M4dm0nky/madbuddy/docs/einbau-kamera-roboter.pdf

# 📷 Kamera und XIAO in den Roboter einbauen

MadBuddy Stufe 3 „Roboter“ · Dauer ca. 10 Minuten · kein Kleber, kein Löten bei diesem Schritt

## 🧩 Das Prinzip

Die Kamera sitzt innen in der Brust und schaut durch ein kleines Loch (Ø 7,4 mm) nach vorn. Kamera und XIAO bleiben so, wie sie geliefert werden: Die Kameraplatine steckt auf dem XIAO über dem SD-Steckplatz. Beides geht als ein Block von hinten in die Brust. Kein Riegel, kein Kleber, keine Schrauben an dieser Stelle. Alle Bilder zeigen das Brust-Vorderteil von hinten, so wie es vor dir liegt, wenn die Rückwand ab ist.

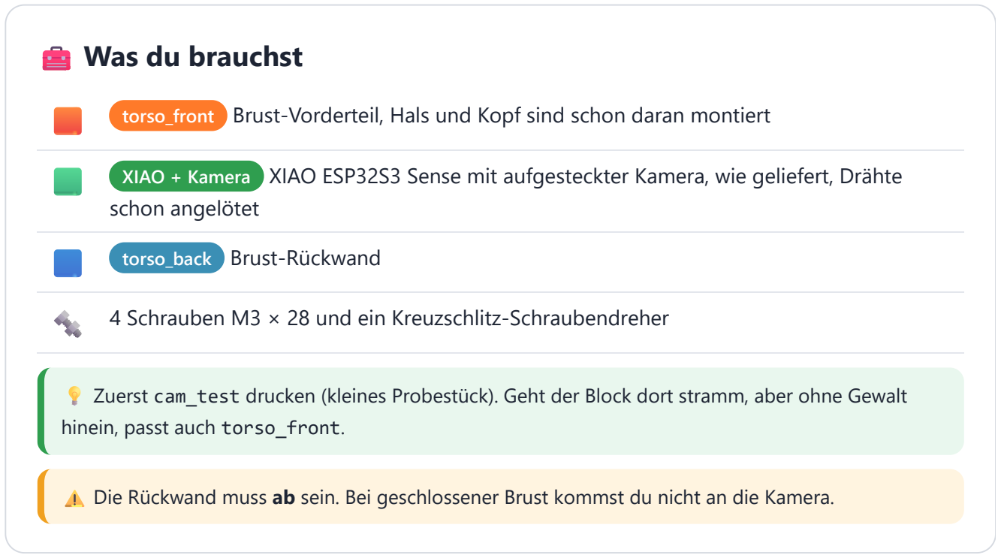
[picture p6: figure]
🧰 Was du brauchst; schon angelötet; torso_back Brust-Rückwand; hinein, passt auch torso_front.

🟧 | torso_front Brust-Vorderteil, Hals und Kopf sind schon daran montiert
🟩 | XIAO + Kamera XIAO ESP32S3 Sense mit aufgesteckter Kamera, wie geliefert, Drähte

🔩 4 Schrauben M3 × 28 und ein Kreuzschlitz-Schraubendreher

💡 Zuerst cam_test drucken (kleines Probestück). Geht der Block dort stramm, aber ohne Gewalt

⚠️ Die Rückwand muss ab sein. Bei geschlossener Brust kommst du nicht an die Kamera.

## 1 Leere Tasche

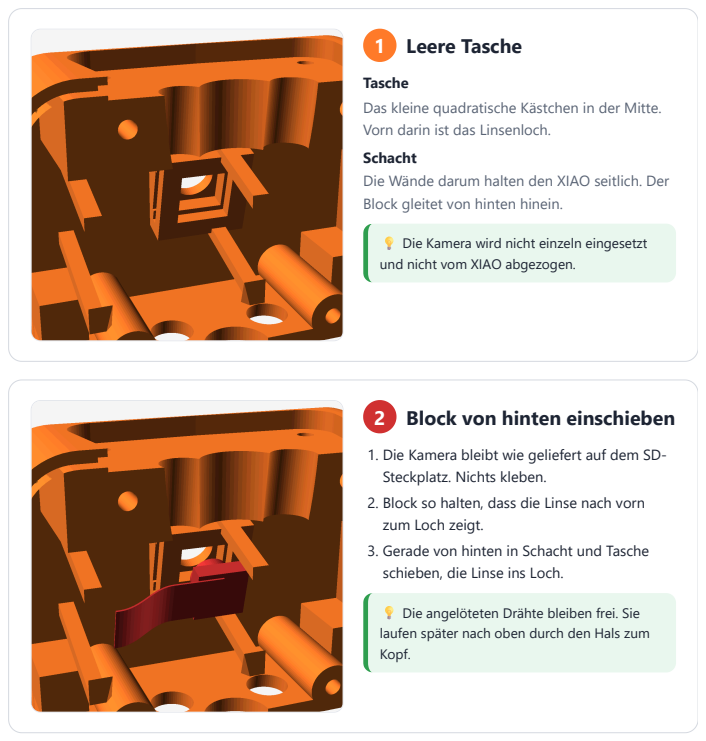
[picture p7: page 2]

Tasche
Das kleine quadratische Kästchen in der Mitte.
Vorn darin ist das Linsenloch.
Schacht
Die Wände darum halten den XIAO seitlich. Der
Block gleitet von hinten hinein.

💡 Die Kamera wird nicht einzeln eingesetzt
und nicht vom XIAO abgezogen.

2 Block von hinten einschieben

1. Die Kamera bleibt wie geliefert auf dem SD-
Steckplatz. Nichts kleben.
2. Block so halten, dass die Linse nach vorn
zum Loch zeigt.
3. Gerade von hinten in Schacht und Tasche
schieben, die Linse ins Loch.

💡 Die angelöteten Drähte bleiben frei. Sie
laufen später nach oben durch den Hals zum
Kopf.

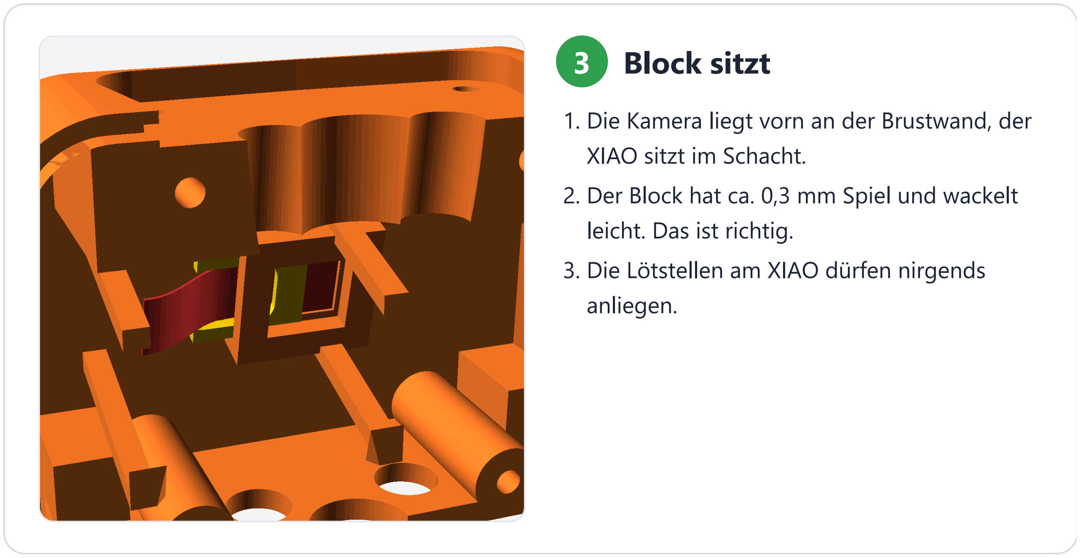
[picture p8: figure]
3 Block sitzt; XIAO sitzt im Schacht.; leicht. Das ist richtig.; anliegen.

1. Die Kamera liegt vorn an der Brustwand, der
2. Der Block hat ca. 0,3 mm Spiel und wackelt
3. Die Lötstellen am XIAO dürfen nirgends

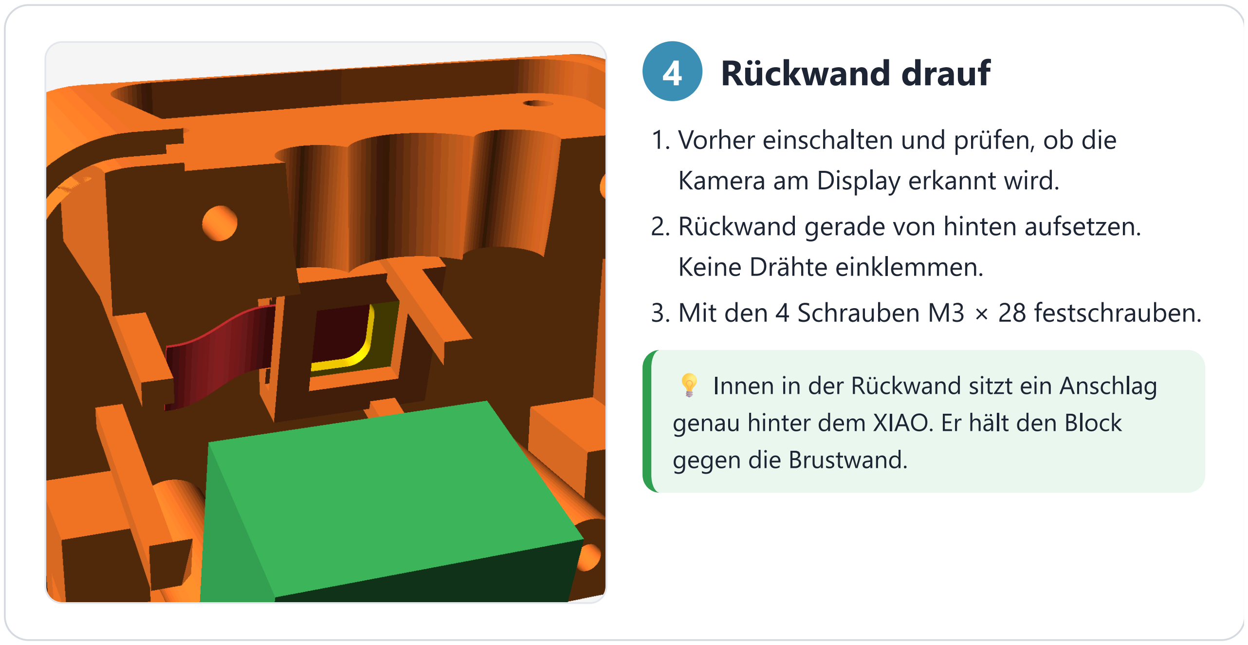
[picture p9: figure]
4 Rückwand drauf; Kamera am Display erkannt wird.; Keine Drähte einklemmen.; gegen die Brustwand.

1. Vorher einschalten und prüfen, ob die
2. Rückwand gerade von hinten aufsetzen.
3. Mit den 4 Schrauben M3 × 28 festschrauben.

💡 Innen in der Rückwand sitzt ein Anschlag genau hinter dem XIAO. Er hält den Block

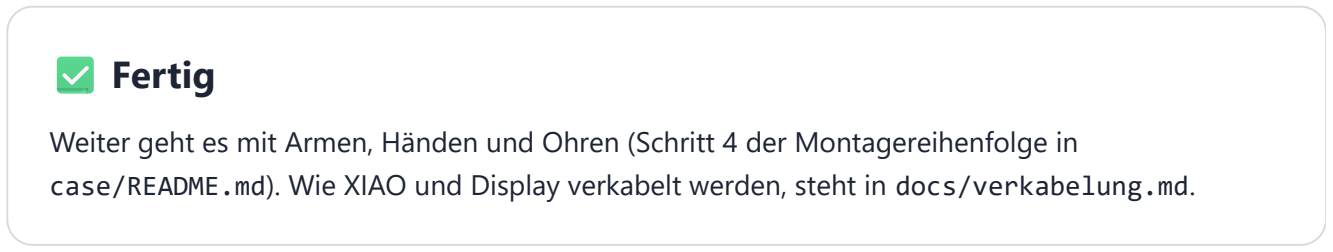
[picture p10: figure]
✅ Fertig

Weiter geht es mit Armen, Händen und Ohren (Schritt 4 der Montagereihenfolge in case/README.md). Wie XIAO und Display verkabelt werden, steht in docs/verkabelung.md.

MadBuddy · Bilder aus dem Gehäusemodell (case/tools/render_guide.ps1) · Stand 2026-11-06
