M4dm0nky/madbuddy/case/render/madbuddy_front.png

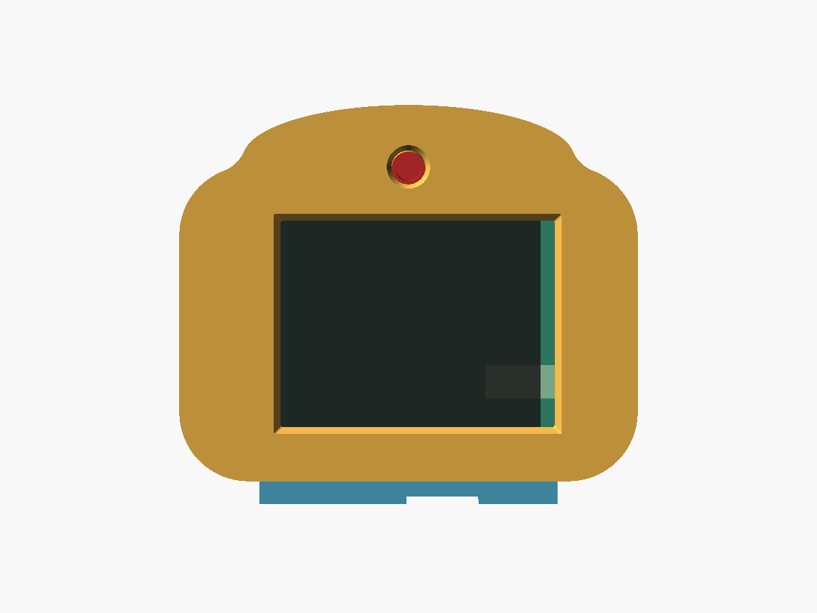
case/render/madbuddy_front.png
