M4dm0nky/madbuddy/case/render/madbuddy_hinten.png

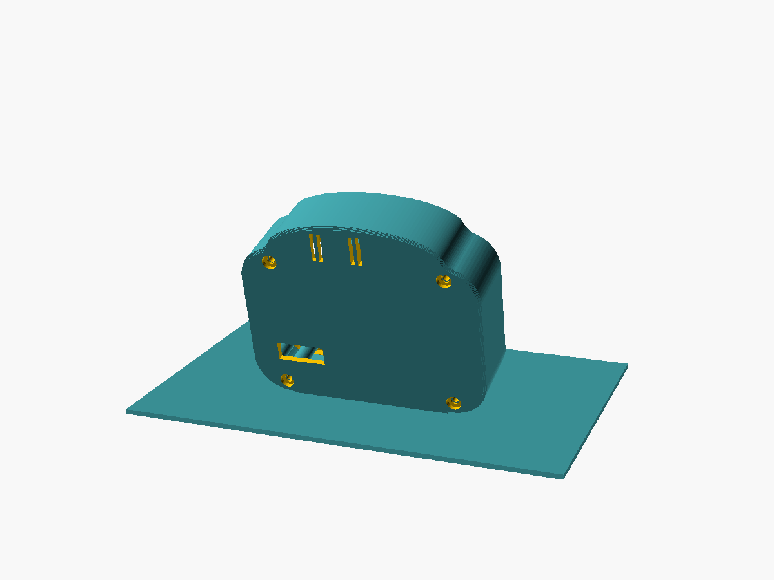
case/render/madbuddy_hinten.png
