M4dm0nky/madbuddy/case/render/madbuddy_kamera_schnitt.png

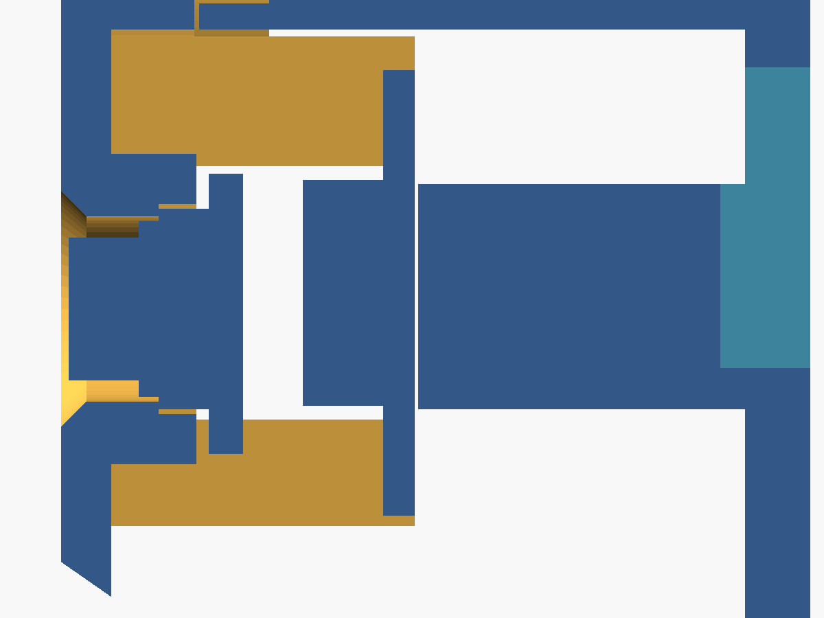
case/render/madbuddy_kamera_schnitt.png
