M4dm0nky/madbuddy/case/render/madbuddy_schnitt.png

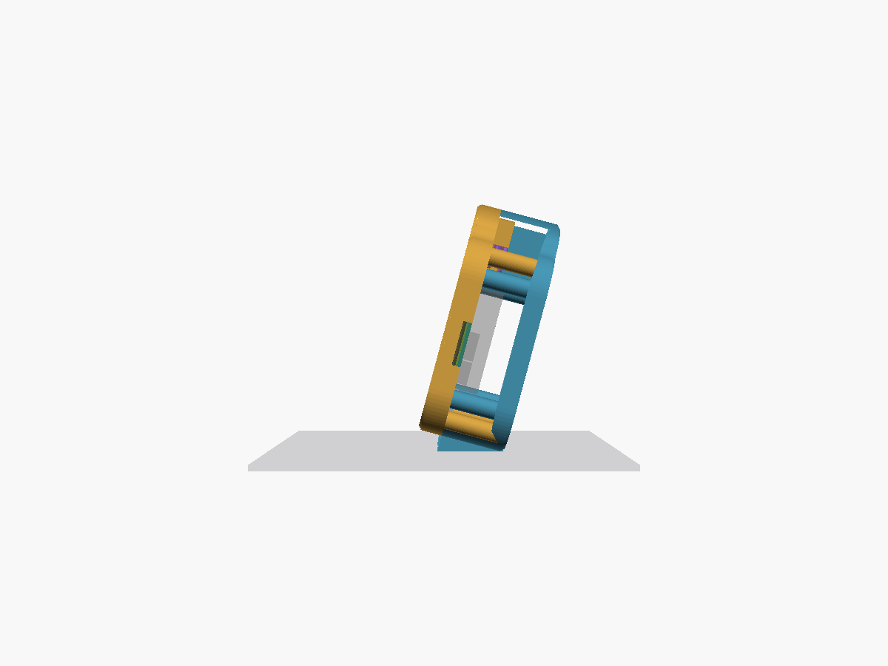
case/render/madbuddy_schnitt.png
