M4dm0nky/madbuddy/case/render/roboter_exploded.png

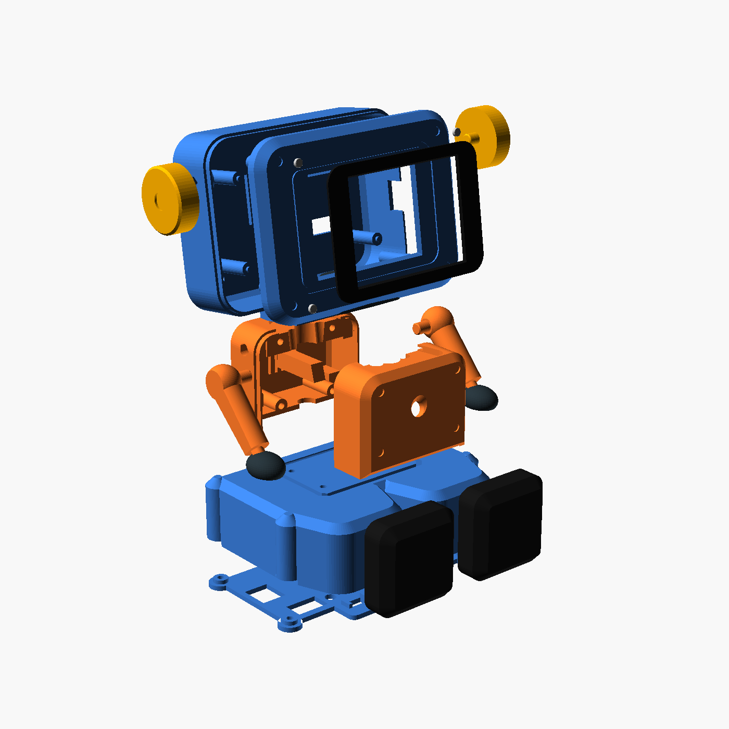
case/render/roboter_exploded.png
