M4dm0nky/madbuddy/case/render/roboter_section.png

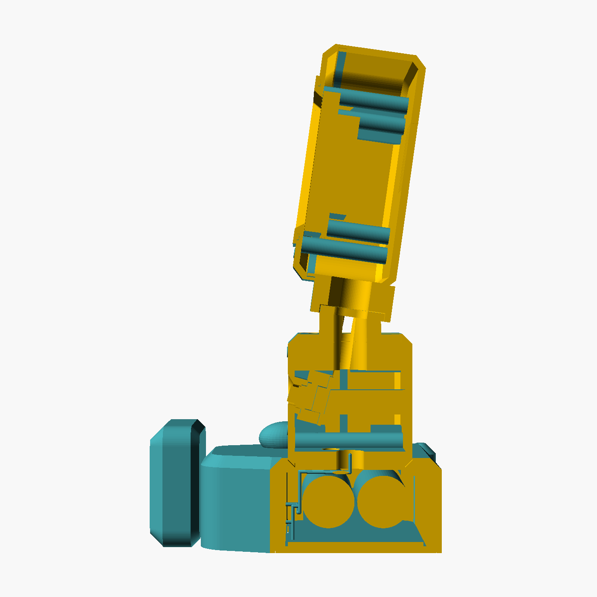
case/render/roboter_section.png
