M4dm0nky/madbuddy/case/stl/roboter_deco.stl

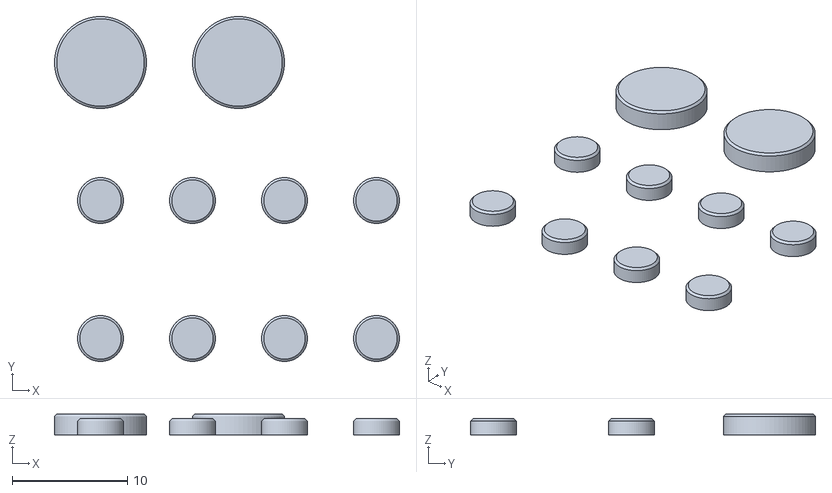
[picture p18: CAD file, 2026-11-06]
case/stl/roboter_deco.stl
30.0 x 30.0 x 1.80
