M4dm0nky/madbuddy/case/3mf/roboter_ams.3mf

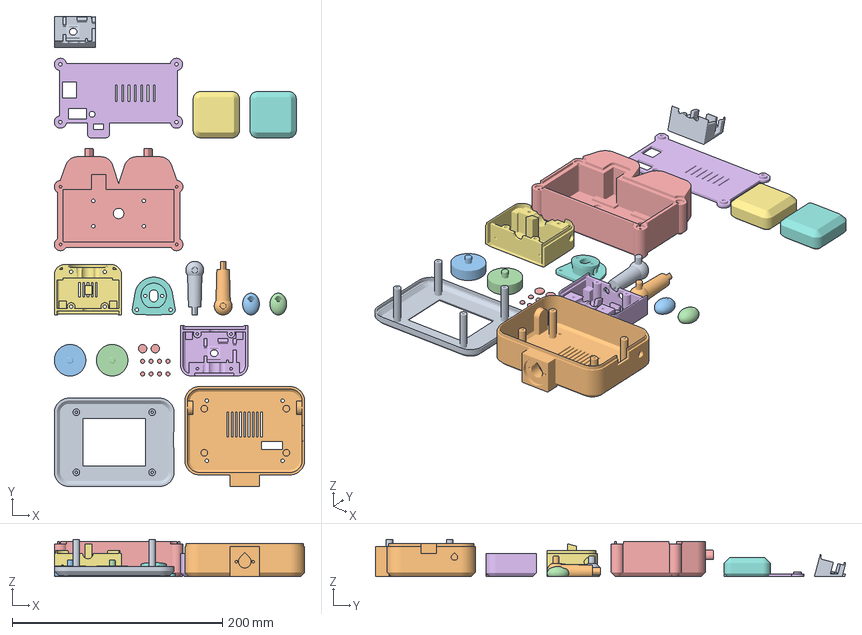
[picture p19: CAD file, 2026-11-05]
case/3mf/roboter_ams.3mf
238.0 x 446.7 x 35.5 mm
kopf
head_back
ear_r
ear_l
deco
torso_front
torso_back
neck
arm_r
arm_l
hand_r
hand_l
seat
bottom
foot_r
foot_l
cam_test
