M4dm0nky/madbuddy/case/stl/roboter_ear.stl

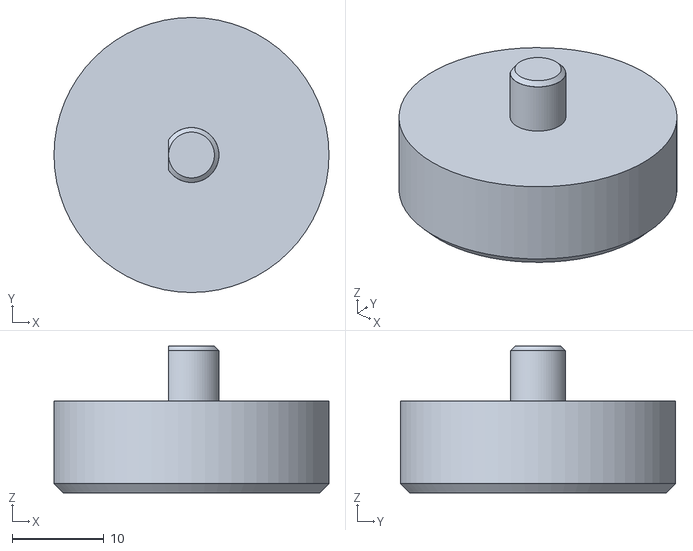
[picture p20: CAD file, 2026-11-06]
case/stl/roboter_ear.stl
30.0 x 30.0 x 16.0
