M4dm0nky/madbuddy/case/stl/roboter_hand.stl

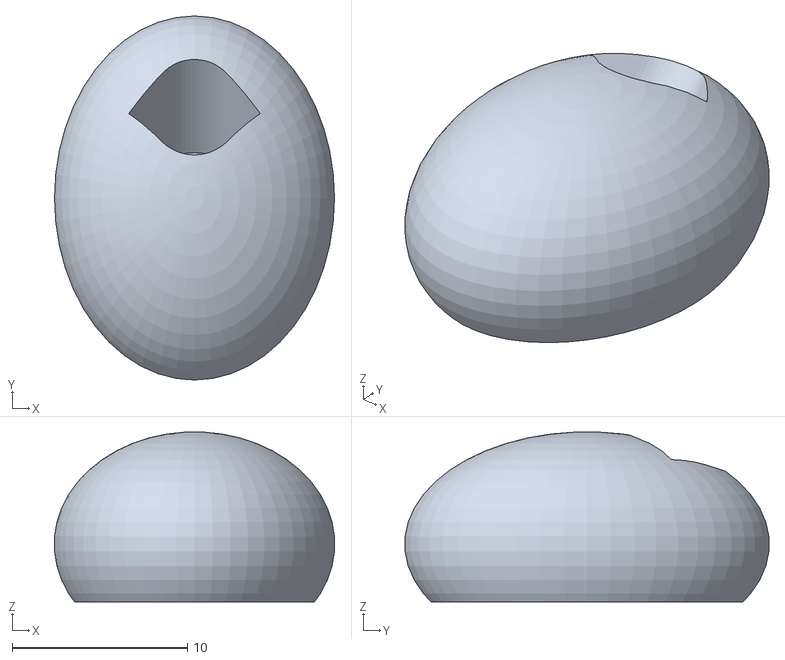
[picture p21: CAD file, 2026-11-06]
case/stl/roboter_hand.stl
16.0 x 20.8 x 9.69
