M4dm0nky/madbuddy/case/stl/roboter_foot.stl

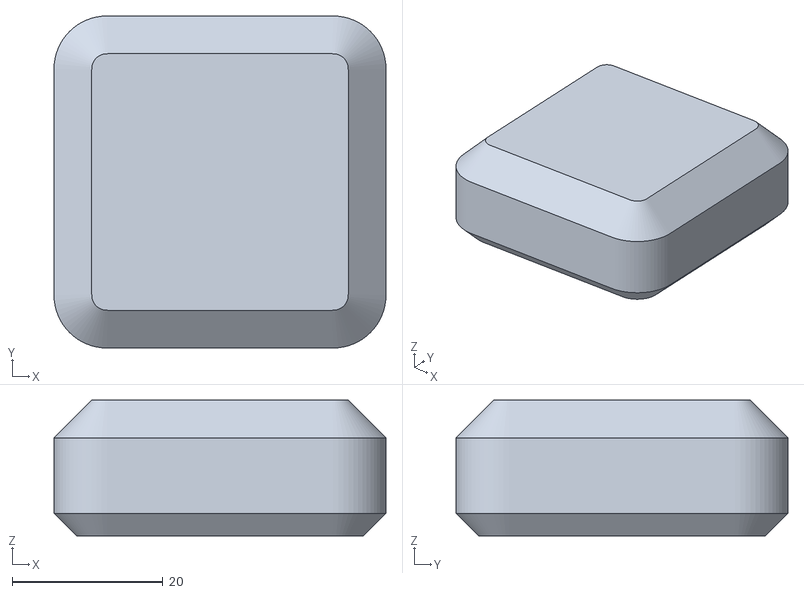
[picture p22: CAD file, 2026-11-06]
case/stl/roboter_foot.stl
44.0 x 44.0 x 18.0
