M4dm0nky/madbuddy/case/stl/roboter_arm.stl

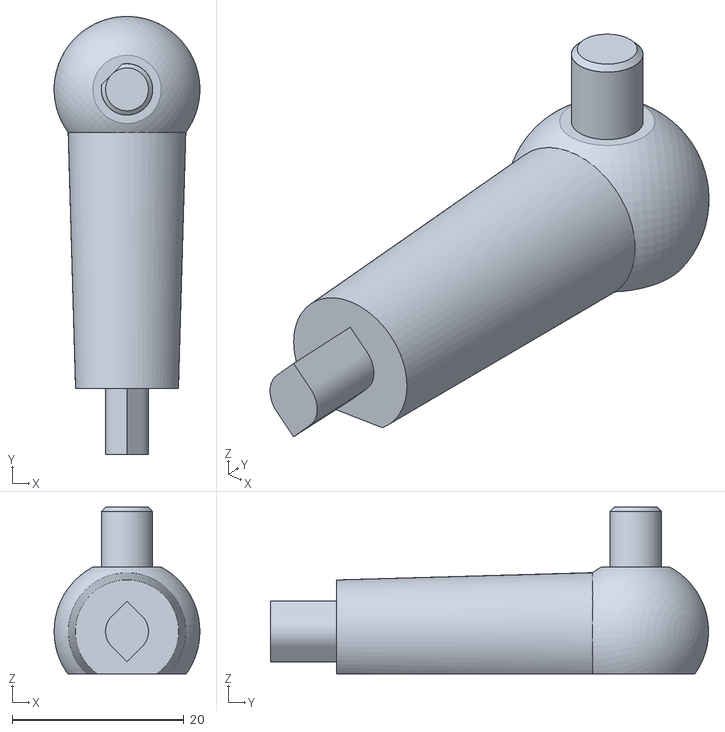
[picture p23: CAD file, 2026-11-06]
case/stl/roboter_arm.stl
17.0 x 51.0 x 19.4
