M4dm0nky/madbuddy/case/stl/roboter_cam_test.stl

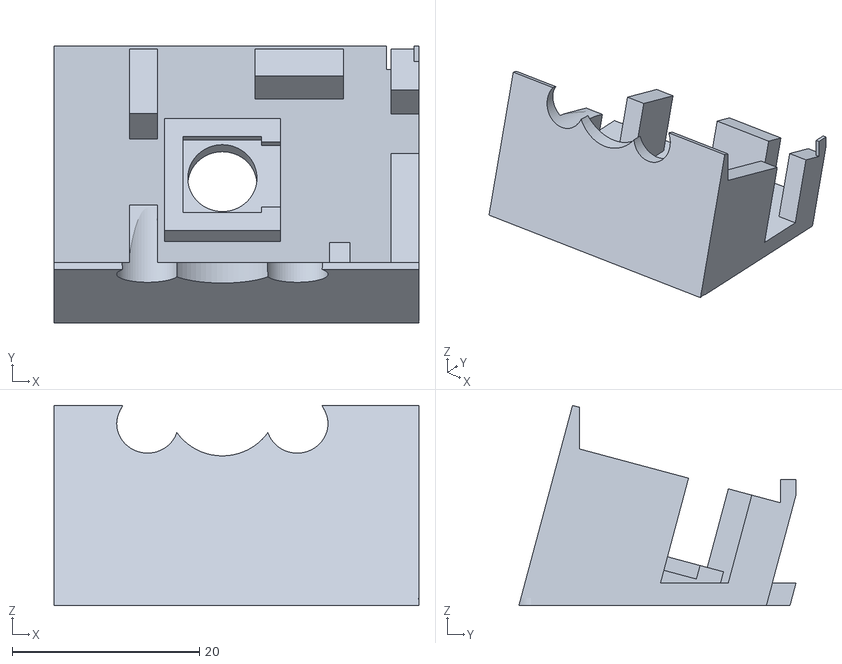
[picture p24: CAD file, 2026-11-06]
case/stl/roboter_cam_test.stl
39.0 x 29.6 x 21.4
