M4dm0nky/madbuddy/case/stl/roboter_bezel_inlay.stl

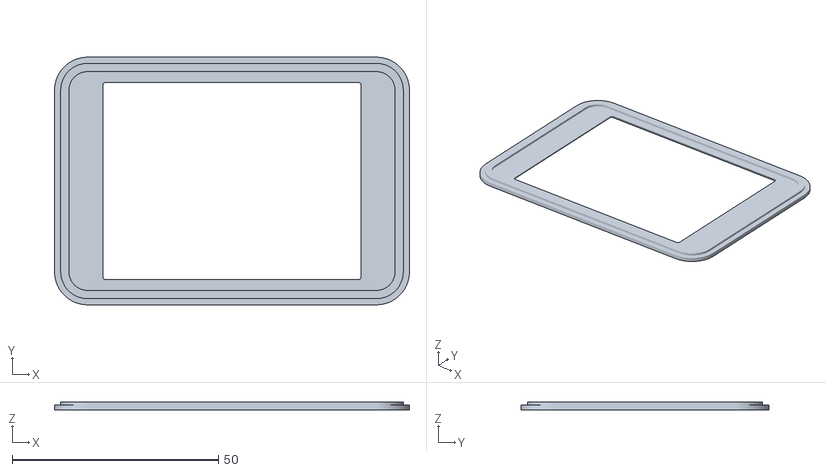
[picture p25: CAD file, 2026-11-06]
case/stl/roboter_bezel_inlay.stl
86.0 x 60.0 x 1.90
