M4dm0nky/madbuddy/case/stl/roboter_head_front_ams.stl

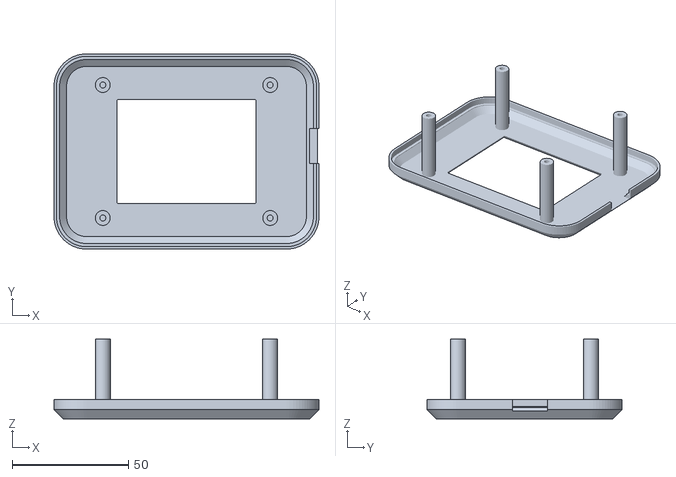
[picture p26: CAD file, 2026-11-06]
case/stl/roboter_head_front_ams.stl
114.0 x 84.0 x 34.3
