M4dm0nky/madbuddy/case/stl/madbuddy_frame_test.stl

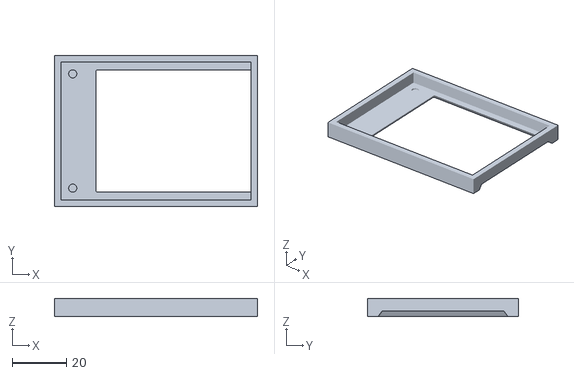
[picture p27: CAD file, 2026-11-06]
case/stl/madbuddy_frame_test.stl
74.6 x 55.4 x 6.70
