M4dm0nky/madbuddy/case/stl/roboter_neck.stl

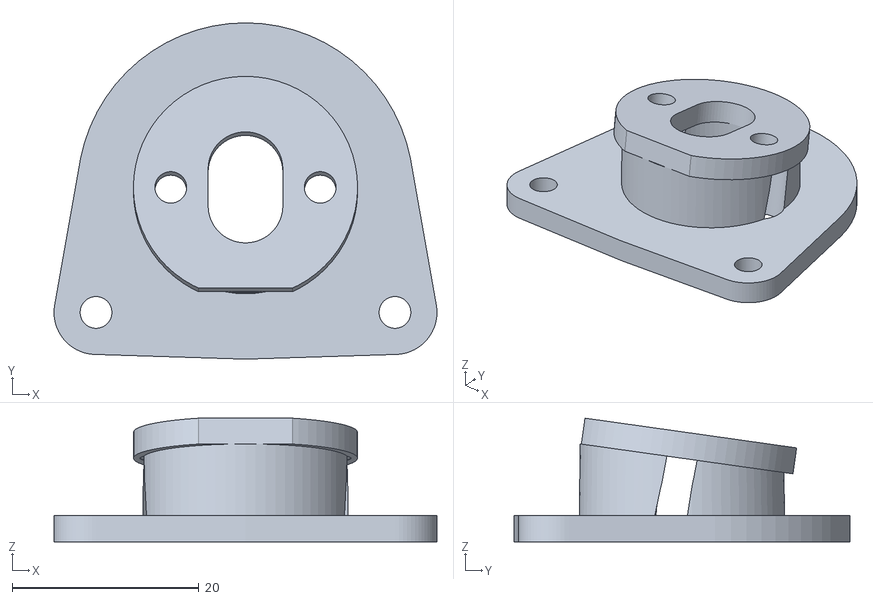
[picture p28: CAD file, 2026-11-06]
case/stl/roboter_neck.stl
41.0 x 36.0 x 13.2
