M4dm0nky/madbuddy/case/stl/madbuddy_cam_test.stl

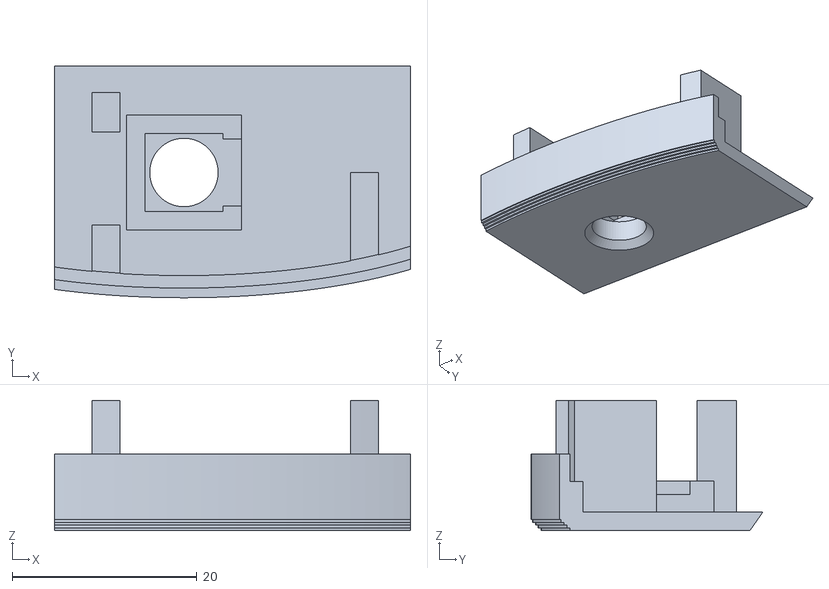
[picture p29: CAD file, 2026-11-06]
case/stl/madbuddy_cam_test.stl
38.5 x 25.0 x 14.1
