M4dm0nky/madbuddy/case/stl/roboter_head_back.stl

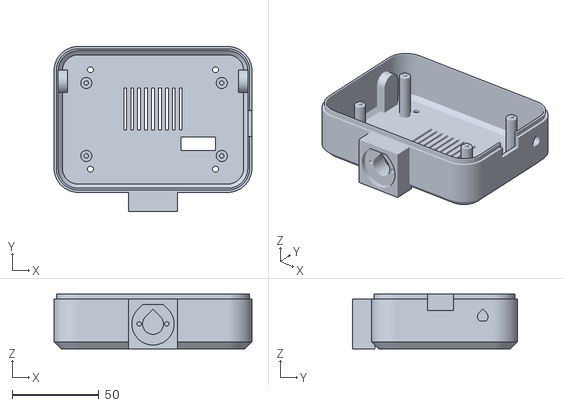
[picture p30: CAD file, 2026-11-06]
case/stl/roboter_head_back.stl
114.0 x 95.0 x 31.4
