M4dm0nky/madbuddy/case/stl/madbuddy_front.stl

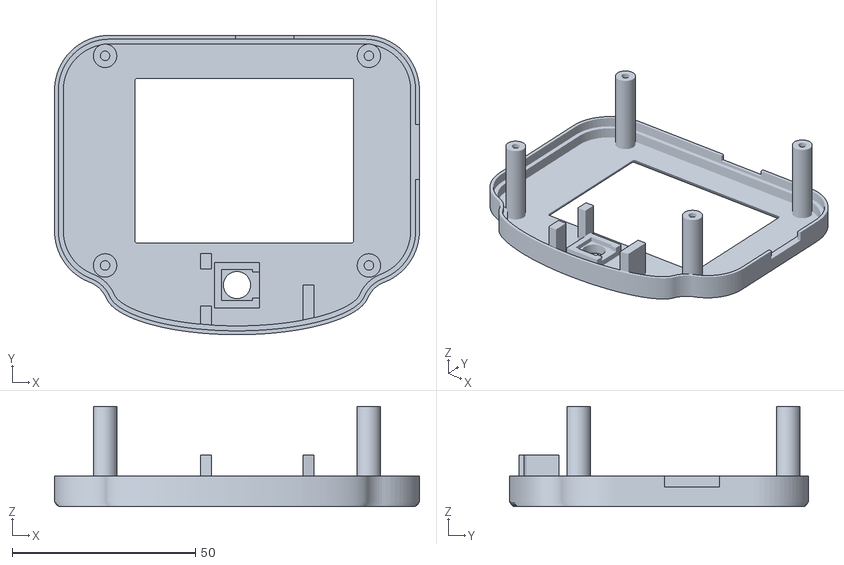
[picture p31: CAD file, 2026-11-06]
case/stl/madbuddy_front.stl
99.6 x 81.7 x 27.3
