M4dm0nky/madbuddy/case/stl/roboter_seat.stl

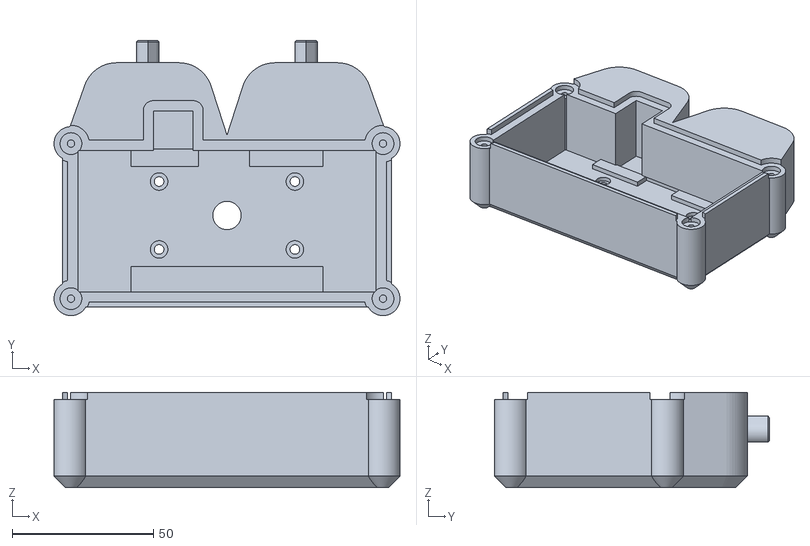
[picture p32: CAD file, 2026-11-06]
case/stl/roboter_seat.stl
122.3 x 97.3 x 33.6
