M4dm0nky/madbuddy/case/stl/madbuddy_back.stl

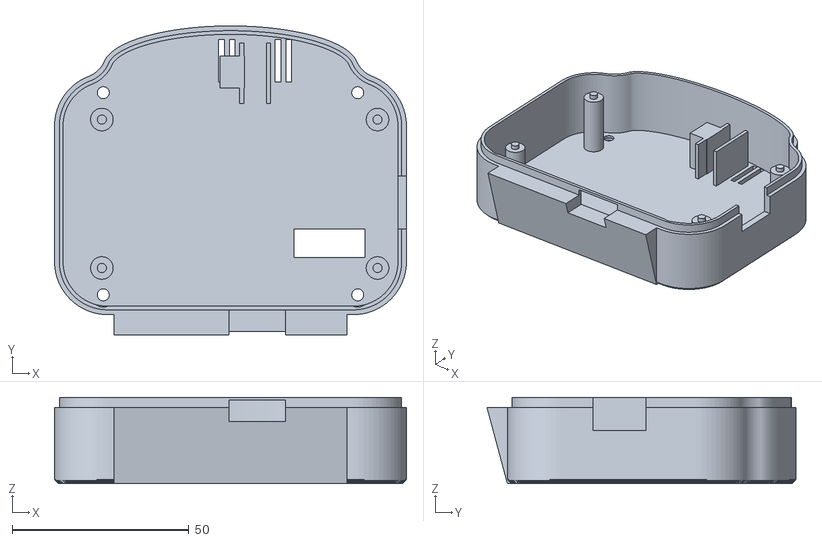
[picture p33: CAD file, 2026-11-06]
case/stl/madbuddy_back.stl
99.6 x 87.5 x 24.4
