M4dm0nky/madbuddy/case/stl/roboter_torso_back.stl

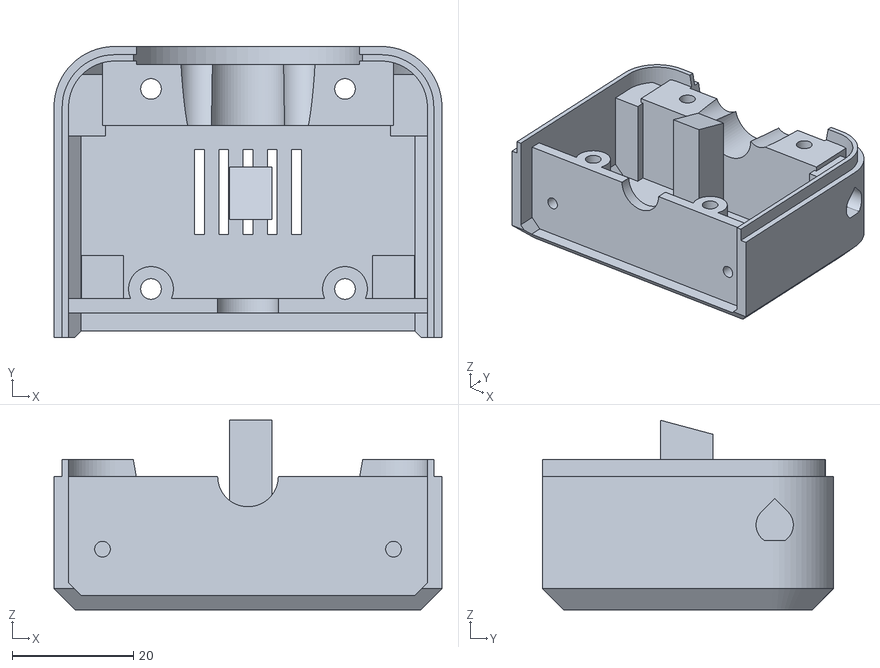
[picture p34: CAD file, 2026-11-06]
case/stl/roboter_torso_back.stl
64.0 x 48.0 x 31.3
