M4dm0nky/madbuddy/case/stl/roboter_bottom.stl

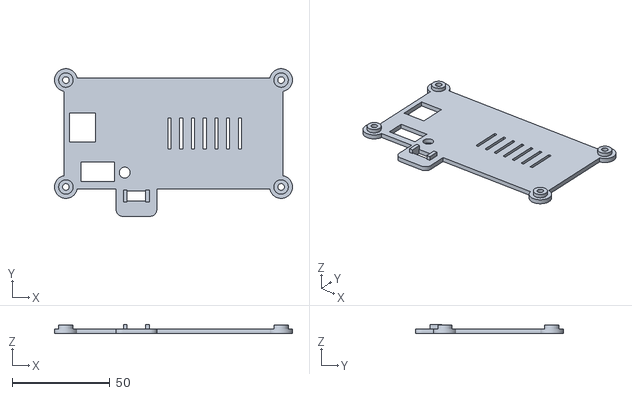
[picture p35: CAD file, 2026-11-06]
case/stl/roboter_bottom.stl
122.0 x 75.7 x 4.58
