M4dm0nky/madbuddy/case/stl/roboter_torso_front.stl

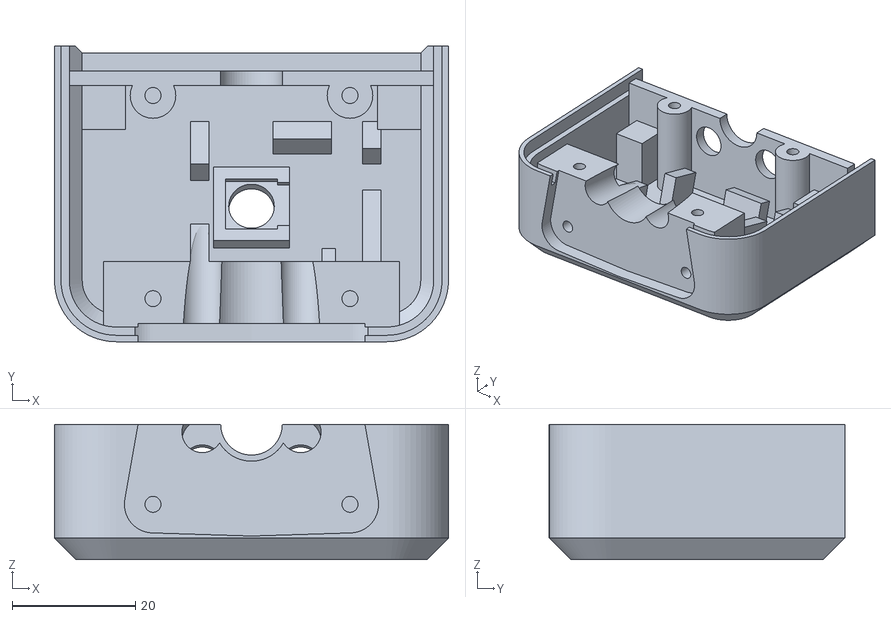
[picture p36: CAD file, 2026-11-06]
case/stl/roboter_torso_front.stl
64.0 x 48.0 x 22.0
