M4dm0nky/madbuddy/(list of files, cad)

Other CAD files:
case/stl/roboter_arm_l.stl
case/stl/roboter_head_front.stl
case/stl/roboter_bezel.stl
case/stl/roboter_screws_inlay.stl
