M4dm0nky/madbuddy/case/render/roboter_assembly.png

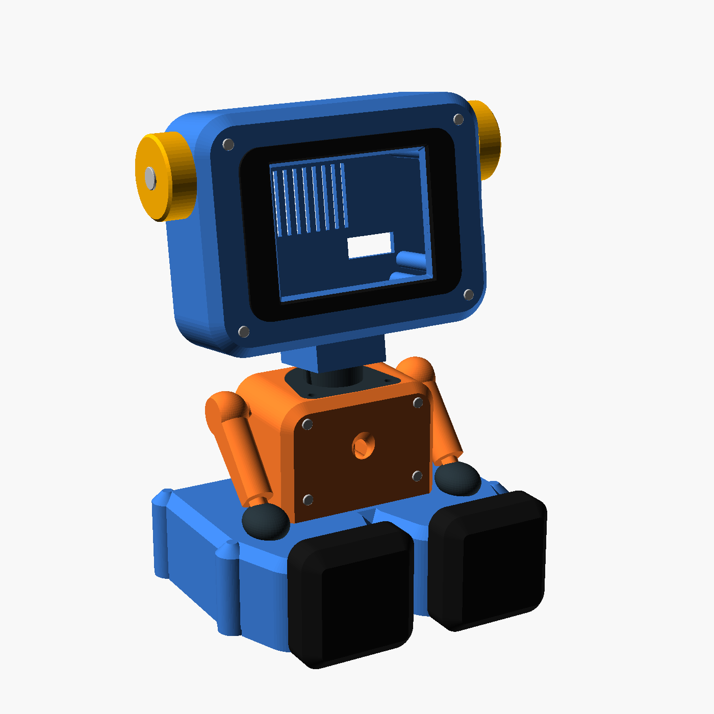
case/render/roboter_assembly.png
