M4dm0nky/madbuddy/cam/src/main.cpp

#include <Arduino.h>
#include <esp_camera.h>
#include <esp_task_wdt.h>
#include <img_converters.h>
#include <mbedtls/base64.h>
#include "cam_config.h"
#include "camera.h"
#include "detect.h"
#include "motion.h"
#include "link.h"
#include "updater.h"
#include "logic/cam_proto.h"
#include "logic/cam_xiao.h"

// XIAO ESP32S3 Sense: Gesichter erkennen und dem CYD melden (Spec docs/superpowers/specs/2026-10-26-kamera-firmware-design.md).
// Bilder verlassen den XIAO nie; WLAN nur während eines Updates.

// Nach einem Update bestätigt erst der Probelauf das Image (updater_health_tick), nicht der Core beim Start.
extern "C" bool verifyRollbackLater() { return true; }

static bool g_want_on = true;     // Vorgabe an; der CYD schickt nach jedem Neustart C 1/C 0
static CamState g_state = CAM_ST_OFF;
static bool g_ever_ok = false, g_had_err = false;
static uint32_t g_last_heart = 0, g_last_retry = 0, g_beats = 0, g_fb_fail = 0;
static uint32_t g_stat_t0 = 0, g_frames = 0, g_ms_sum = 0, g_dets = 0, g_rot_sum = 0, g_frame_no = 0;
static int clamp9999(uint32_t v) { return v > 9999 ? 9999 : (int)v; }
static CamFace g_last = {0, 0, 0};
static bool g_has = false;
static uint32_t g_last_motion = 0, g_motions = 0;

static void wipe_msg(CamMsg &m) {
  volatile char *p = m.pass;
  for (size_t i = 0; i < sizeof m.pass; i++) p[i] = 0;
}

static void send_heart() {
  char b[48];
  const size_t n = cam_build_heart(CAM_FW_VERSION, g_state, b, sizeof b);
  link_send(b, n);
  g_beats++;
}

// Eine Textzeile versiegelt an den CYD (J-Zeilen des Schnappschusses)
static void send_j(const char *content) {
  char b[CAM_LINE_MAX + 8];
  const size_t n = cam_seal(content, b, sizeof b);
  if (n) link_send(b, n, false);
}

// Diagnose-Schnappschuss auf ausdrückliche Anfrage (P): ein Bild als JPEG in Textzeilen. Sonst verlassen Bilder den XIAO nie.
static void send_snapshot() {
  if (!camera_running()) { send_j("J X cam_off"); return; }
  camera_fb_t *fb = esp_camera_fb_get();
  if (!fb) { send_j("J X no_frame"); return; }
  uint8_t *jpg = nullptr;
  size_t len = 0;
  int rw, rh;
  camera_fb_t rot = *fb;   // gedrehte Sicht auf das Bild (Puffer aus camera_rotated)
  rot.buf = (uint8_t *)camera_rotated(fb, &rw, &rh);
  rot.width = rw; rot.height = rh;
  const bool ok = frame2jpg(&rot, 80, &jpg, &len);
  esp_camera_fb_return(fb);
  if (!ok || !jpg || len == 0) { if (jpg) free(jpg); send_j("J X jpeg_fail"); return; }
  char c[CAM_LINE_MAX];
  snprintf(c, sizeof c, "J B %u", (unsigned)len);
  send_j(c);
  uint32_t seq = 0;
  for (size_t off = 0; off < len; off += 222, seq++) {
    const size_t chunk = len - off < 222 ? len - off : 222;
    int h = snprintf(c, sizeof c, "J D %u ", (unsigned)seq);
    size_t olen = 0;
    if (mbedtls_base64_encode((unsigned char *)c + h, sizeof c - h, &olen, jpg + off, chunk) != 0) { send_j("J X b64_fail"); free(jpg); return; }
    c[h + olen] = '\0';
    send_j(c);
    // Ein großes Bild dauert über 2 s: Lebenszeichen nicht ausfallen lassen (cam-snap.py überliest Nicht-J-Zeilen)
    feedLoopWDT();   // ein großes Bild dauert länger als die loop()-Überwachung
    if (millis() - g_last_heart >= CAM_HEART_MS) { g_last_heart = millis(); send_heart(); }
  }
  free(jpg);
  send_j("J E");
}

static void set_err() {
  camera_stop();
  g_state = CAM_ST_ERR;
  g_had_err = true;
  g_last_retry = millis();
}

static void apply_camera() {
  motion_reset();   // nach Kamera aus/an kein Vergleich mit einem alten Bild
  if (!g_want_on) {
    camera_stop();
    g_state = CAM_ST_OFF;
    return;
  }
  if (camera_running()) { g_state = CAM_ST_ON; return; }
  if (camera_start()) { g_state = CAM_ST_ON; g_ever_ok = true; g_fb_fail = 0; }
  else set_err();
}

void setup() {
  Serial.begin(115200);
  link_begin();
  updater_boot();
  Serial.printf("# cam %s psram=%u detect=%d\n", CAM_FW_VERSION, (unsigned)ESP.getPsramSize(), detect_init());
  apply_camera();
  send_heart();
  g_last_heart = g_stat_t0 = millis();
  // Watchdog der loop(): 30 s mit Reset; sdkconfig.defaults setzt dasselbe, das hier sichert es ab.
  const esp_task_wdt_config_t wdt = {.timeout_ms = 30000, .idle_core_mask = 0, .trigger_panic = true};
  if (esp_task_wdt_reconfigure(&wdt) != ESP_OK) esp_task_wdt_init(&wdt);
  enableLoopWDT();   // der Kern füttert ihn nach jedem loop(); lange Abschnitte rufen feedLoopWDT()
}

void loop() {
  const uint32_t now = millis();
  CamMsg m;
  while (link_poll(&m)) {
    if (m.kind == CAM_CTRL) {
      g_want_on = m.on;
      apply_camera();
      send_heart();
    } else if (m.kind == CAM_SNAP_CMD) {
      send_snapshot();
    } else if (m.kind == CAM_UPD_CMD) {
      camera_stop();               // Speicher und Rechenzeit fürs Update
      g_state = CAM_ST_OFF;
      updater_run(m, send_heart);  // kehrt nur bei Fehler zurück
      wipe_msg(m);                 // Passwort aus dem Speicher
      link_wipe();
      apply_camera();
    }
  }
  if (g_want_on && g_state == CAM_ST_ERR && now - g_last_retry >= CAM_RETRY_MS) apply_camera();
  if (now - g_last_heart >= CAM_HEART_MS) { g_last_heart = now; send_heart(); }
  updater_health_tick(now, g_ever_ok && !g_had_err, g_beats);

  if (camera_running()) {
    camera_fb_t *fb = esp_camera_fb_get();
    if (!fb) {
      if (++g_fb_fail >= 10) set_err();   // Sensor liefert nicht mehr
      delay(10);
      return;
    }
    g_fb_fail = 0;
    MotionResult mo;
    const bool moving = motion_detect(fb, &mo);   // jedes Bild, vor dem Zurückgeben des Bildes
    g_frame_no++;
    if (g_frame_no % CAM_DETECT_EVERY == 0) {   // Gesichtserkennung nur jedes n-te Bild
      CamFace f;
      uint32_t ms = 0;
      const uint32_t t0 = millis();
      int rw, rh;
      const uint8_t *px = camera_rotated(fb, &rw, &rh);   // aufrechtes Bild (Einbaulage)
      g_rot_sum += millis() - t0;
      g_has = detect_face(px, rw, rh, &f, &ms);
      esp_camera_fb_return(fb);
      if (g_has) g_last = f;
      char b[32];
      const size_t n = g_has ? cam_build_face(f.x, f.y, f.w, b, sizeof b) : cam_build_noface(b, sizeof b);
      link_send(b, n, false);   // F/N nicht auf USB, dafür die Messzeile unten
      g_dets++;
      g_ms_sum += ms;
    } else {
      esp_camera_fb_return(fb);
    }
    if (moving && (g_motions == 0 || now - g_last_motion >= MOT_SEND_MS)) {   // höchstens alle 250 ms ein M
      char mb[32];
      const size_t mn = cam_build_motion(mo.x, mo.y, mo.n, mb, sizeof mb);
      link_send(mb, mn, false);
      g_last_motion = now;
      g_motions++;
    }
    g_frames++;
  } else {
    delay(20);
  }
  if (now - g_stat_t0 >= 1000) {
    const uint32_t rot = g_dets ? g_rot_sum / g_dets : 0, det = g_dets ? g_ms_sum / g_dets : 0;
    Serial.printf("# fps=%u dps=%u rot=%u ms=%u face=%d %d,%d,%d\n", (unsigned)g_frames, (unsigned)g_dets, (unsigned)rot,
                  (unsigned)det, g_has, g_last.x, g_last.y, g_last.w);
    char sb[40];
    const size_t sn = cam_build_stats(clamp9999(g_frames), clamp9999(g_dets), clamp9999(rot), clamp9999(det), sb, sizeof sb);
    link_send(sb, sn, false);
    g_stat_t0 = now;
    g_frames = 0;
    g_dets = 0;
    g_ms_sum = 0;
    g_rot_sum = 0;
  }
}
