M4dm0nky/madbuddy/cam/src/detect.h

#pragma once
#include <stdint.h>
#include <esp_camera.h>
#include "logic/cam_xiao.h"
bool detect_init();
bool detect_face(const uint8_t *px, int w, int h, CamFace *out, uint32_t *infer_ms);   // true = Gesicht, out = größtes
