M4dm0nky/madbuddy/src/hw/cam_uart.h

#pragma once
#include <stdint.h>
#include <stddef.h>
#include "../logic/cam_link.h"

// Kamera-Leitung zum XIAO (Serial2): Bytes lesen, Zeilen prüfen, Meldungen weitergeben.
void cam_uart_begin();
void cam_uart_poll(uint32_t now);                              // liest alle verfügbaren Bytes (höchstens 1024 je Aufruf)
void cam_uart_send(const char *content);                       // versiegelt (cam_seal) und schreibt
void cam_uart_write_sealed(const char *line, size_t n);       // schon versiegelte Zeile (z. B. cam_build_upd_cmd) unverändert schreiben; Puffer löscht der Aufrufer
void cam_uart_send_ctrl(bool on);                              // C 1 / C 0
bool cam_uart_take_restart();                                  // true einmal nach erstem H bzw. Trennung
const CamLink &cam_uart_link();
void cam_uart_upd_start(uint32_t now);                         // Update-Überwachung starten (U-Zeile wurde gesendet)
bool cam_uart_upd_timed_out(uint32_t now);                     // bleibt wahr, bis cam_uart_upd_end() gerufen wird
void cam_uart_upd_end();
void cam_uart_snap(uint32_t now);                              // Diagnose-Schnappschuss anfordern (P), 8 s lang alle XIAO-Bytes roh an USB durchreichen
bool cam_uart_snap_active(uint32_t now);
void cam_uart_on_msg(void (*fn)(const CamMsg &, uint32_t now));
