M4dm0nky/madbuddy/(commit log)

2026-11-01 fix(cam): detect_face schuetzt vor fehlendem Detektor
    [detect.cpp]
2026-11-01 feat(cam): Box-Umrechnung, Probelauf-Entscheidung, S3-Chip in der Image-Pruefung
2026-11-01 feat(cam): XIAO-Firmware mit Protokoll, Kamera an/aus, WLAN-Update und Rollback
2026-11-01 fix(cam): WLAN-Zugangsdaten nicht speichern, Herzschlag beim Umleiten, Passwort loeschen
    [link.cpp, link.h, main.cpp, updater.cpp]
2026-11-01 fix(cam): TLS-Handshake-Zeitlimit 6 s, Herzschlag-Stille korrekt dokumentiert
    [updater.cpp]
2026-11-01 feat(cam): cam_link – Zeilen, Verbindung und Update-Watchdog am CYD
2026-11-01 feat(cam): presence – Anwesenheit, Begrüßung, Schlaf, Nähe, Blick
2026-11-01 fix(cam): presence – Begrüßung nach langer Abwesenheit, Sperre über Kamera-Aus, Nähe nur mit frischem Gesicht
2026-11-01 feat(cam): Ausdruck NEAR (schielend) und Sätze WIEDER
2026-11-01 feat(cam): CYD liest die Kamera – Blick, Begrüßung, Schlaf, Nähe
2026-11-01 feat(cam): Einstellungen Seite 2 (Kamera) und Augen-Symbol
2026-11-01 fix(cam): Info-Zeile Seite 1 ohne Überlappung (Font0, 16 Zeichen), XIAO-Text ohne Doppelleerzeichen
    [settings.cpp]
2026-11-01 fix(cam): Kamera-Zeilenansicht nur bei ruhigem CYD-Update, URL ohne Steuerzeichen, cam-Prüfungen in ota-publish
    [ota_card.cpp]
2026-11-02 docs(case): bebilderte Einbauanleitung Kamera und XIAO im Roboter
    Neue Anzeige-Teile guide_1..5 in madbuddy_roboter.scad, Renderskript case/tools/render_guide.ps1, Bilder einbau_kamera_1..5, Anleitung docs/einbau-kamera-roboter.md, Links in beiden READMEs. Druckteile unveraendert.
    [madbuddy_roboter.scad]
2026-11-02 docs: Einbauanleitung Kamera Roboter als HTML und PDF
    Bebilderte Seite docs/einbau-kamera-roboter.html, daraus PDF per Edge headless; READMEs verlinken die PDF.
2026-11-02 docs(spec): Kamera-Halter v2, XIAO und Kamera als Block
2026-11-02 feat(case): Kamera-Halter v2 im Roboter (Block in Lieferlage, ohne Riegel)
    [madbuddy_roboter.scad, roboter_cam_clip.stl, roboter_cam_test.stl, roboter_torso_back.stl, roboter_torso_front.stl, xiao_cam_block.scad]
2026-11-02 fix(case): oberer XIAO-Pfosten hinter den Werkzeugkanal, Testausschnitt ohne frei haengende Teile
    [madbuddy_roboter.scad, roboter_cam_test.stl, roboter_torso_front.stl, xiao_cam_block.scad]
2026-11-03 fix(case): Schacht statt Pfosten mit Rastlippen (Testdruck zu filigran)
    Feste Schachtwaende 3,0 mm um den XIAO-Block, Spiel 0,3, Luecken fuer
    Loetstellen, USB-C, U.FL und Werkzeugkanal; der Anschlag im Rueckteil
    haelt den Block. Pruefung tray_fit je Seite mit Gegenprobe ersetzt
    asm_block_lip. cam_test reicht bis zur Wand am Klappstecker-Ende.
    [madbuddy_roboter.scad, roboter_ams.3mf, roboter_cam_test.stl, roboter_teile.3mf, roboter_torso_front.stl, xiao_cam_block.scad]
2026-11-03 feat(cam): Diagnose-Schnappschuss per USB (snap -> P -> J-Zeilen), Kamera 0.1.1; cam-build erzeugt sdkconfig.cam neu, wenn defaults neuer
    [app.cpp, cam-snap.py, cam_config.h, cam_snap_test.py, cam_uart.cpp, cam_uart.h, link.cpp]
2026-11-03 fix(cam): Update-Watchdog greift, wenn der XIAO den Befehl ignoriert; Diagnosezeile immer mit XIAO-Zustand
    [app.cpp]
2026-11-03 feat(cam): USB-Diagnose der Update-Zeile (uinfo, utest, utestslow), U-Meldungen im Log
2026-11-03 fix(cam): kein Fehlalarm im Probelauf nach U 100; CYD gleicht Kamera-Zustand nach XIAO-Neustart ab
    [app.cpp]
2026-11-03 fix(cam): Schnappschuss am CYD sammeln und am Stueck ueber USB ausgeben (verlor Zeilen)
    [cam_uart.cpp]
2026-11-03 feat(cam): Bild vor Erkennung und Schnappschuss um 90 Grad drehen (Einbaulage Roboter), Kamera 0.1.2
2026-11-03 feat(cam): Anwesenheit auch per Bewegung, Pupillenweg x2.5, Pico-Gesichtsmodell, Kamera 0.1.3
2026-11-03 fix(cam): Blick schneller nachfuehren (Pico ~3 F/s), Diagnosezeile mit M und Bewegung
    [app.cpp]
2026-11-03 docs: Spec und Plan Kamera schneller (0.1.4)
2026-11-03 feat: cam:-Zeile zeigt Messwerte der Kamera
2026-11-03 docs: naechste Aufgaben mit Einstieg und Voraussetzungen
2026-11-03 fix(cam): Snap-Puffer meldet Ueberlauf (J X cyd_puffer_voll), Lebenszeichen beim Snap, write_timeout, Kamera 0.1.6
    [cam-snap.py, cam_config.h, cam_uart.cpp, main.cpp]
2026-11-03 fix(case): Bild 3 mm nach links (aa_left 13), USB-Oeffnung Roboterkopf 2 mm Richtung Gesicht
    [cyd_common.scad, madbuddy_case.scad, madbuddy_frame_test.stl, madbuddy_front.stl, madbuddy_roboter.scad, roboter_ams.3mf, roboter_head_back.stl, roboter_head_front.stl]
2026-11-03 fix(case): CYD-Loecher 3,0 mm gemessen, Zentrierstift 2,6
    [cyd_common.scad, madbuddy_back.stl, madbuddy_frame_test.stl, roboter_ams.3mf, roboter_head_back.stl, roboter_teile.3mf]
2026-11-05 fix: Review Paket A - Kamera-Watchdog, Download-Gesamtzeit, Kamera-URL auf eigenes Repo, kein unsicheres TLS, Wartezeiten ueberlaufsicher (Kamera 0.1.7)
    [app.cpp, cam_config.h, main.cpp, ota_pull.cpp, updater.cpp]
2026-11-05 ci: Host-Tests, Node-Tests und CYD-Build bei jedem Push (Review Paket B)
2026-11-05 feat: Pflege ohne Zwang - kein Hunger, keine Krankheit, nie betruebt oder gelangweilt durch Nichtstun; Fuettern und Spielen geben nur kurze Freude
2026-11-05 fix: Claude-Empfaenger in eigenem Task (Gesicht friert nicht mehr ein), Einrichtungs-WLAN mit Passwort auf dem Display, Schluessel nicht mehr im seriellen Log (Review Paket A)
    [app.cpp, claude_api.cpp, claude_api.h, net.cpp, net.h, settings.cpp, status_bar.cpp, status_bar.h]
2026-11-05 perf: unveraenderte Bilder nicht neu senden, SPI-Takt als Schalter (Env cyd2usb_spi80 zum Testen), fps-Log per CYD_LOG_FPS (Review Paket D)
2026-11-05 case: Lueftung Kopf und Boden, Option Gewindeeinsaetze, gemeinsame Pruefbibliothek, Pruefung 3k; Verkabelung Schutz und Strom (Review Paket E)
    [madbuddy_roboter.scad, roboter_ams.3mf, roboter_bottom.stl, roboter_head_back.stl, roboter_teile.3mf]
2026-11-05 case: Ansichten nach Volllauf (Lueftung sichtbar), Volllauf check_roboter ALLES GRUEN
2026-11-05 feat: Buddy gruesst zurueck, wenn man der Kamera zuwinkt (Schwellen vorlaeufig)
2026-11-05 feat: Display-SPI-Takt 80 MHz als Standard (am Geraet getestet, Rueckfall-Env cyd2usb_spi40)
2026-11-06 feat(case): Kamera-Halter v2 im Kopf Stufe 2 (Endwaende, ohne Riegel)
    [madbuddy_back.stl, madbuddy_cam_clip.stl, madbuddy_cam_test.stl, madbuddy_case.scad, madbuddy_front.stl, xiao_cam_block.scad, xiao_cam_common.scad]
2026-11-06 docs(case): Kamera-Halter v2 – STL, Anleitung, Stufe 2
    [madbuddy_back.stl, madbuddy_cam_test.stl, madbuddy_case.scad, madbuddy_frame_test.stl, madbuddy_front.stl, xiao_cam_block.scad]
2026-11-06 chore(case): Roboter-STL aus Volllauf neu, Linsenloch 7,4 in Anleitung, Plan Stufe 2
    Volllauf check_roboter.ps1 und check.ps1 ALLES GRUEN.
    roboter_torso_back.stl passt wieder zum SCAD.
    [roboter_arm.stl, roboter_arm_l.stl, roboter_bezel.stl, roboter_bezel_inlay.stl, roboter_bottom.stl, roboter_cam_test.stl, roboter_deco.stl, roboter_ear.stl]
